kartikrajchauhan/Latype/BOM/hardware-corpus-cart.jpg

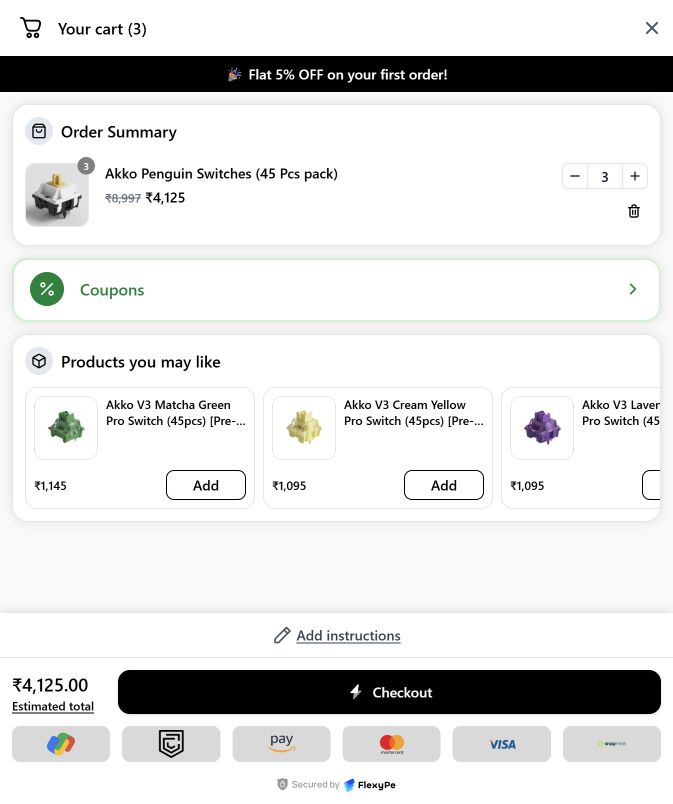
BOM/hardware-corpus-cart.jpg
