kartikrajchauhan/Latype/Images/Screenshot 2026-10-20 131839.png

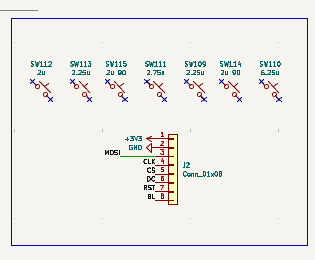
Images/Screenshot 2026-10-20 131839.png
