kartikrajchauhan/Latype/Images/Screenshot 2026-10-20 131844.png

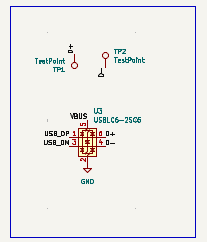
Images/Screenshot 2026-10-20 131844.png
