kartikrajchauhan/Latype/Images/Screenshot 2026-10-20 131846.png

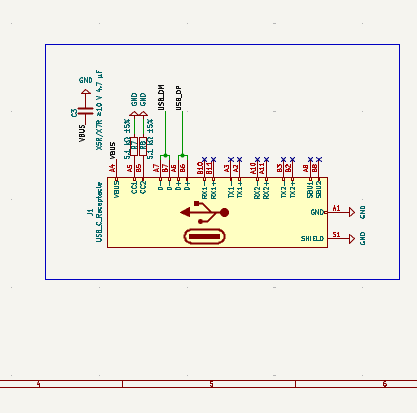
Images/Screenshot 2026-10-20 131846.png
