kartikrajchauhan/Latype/Images/Screenshot 2026-10-20 131850.png

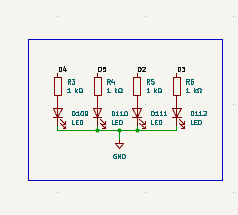
Images/Screenshot 2026-10-20 131850.png
