kartikrajchauhan/Latype/BOM/digikey-cart-components-1.jpg

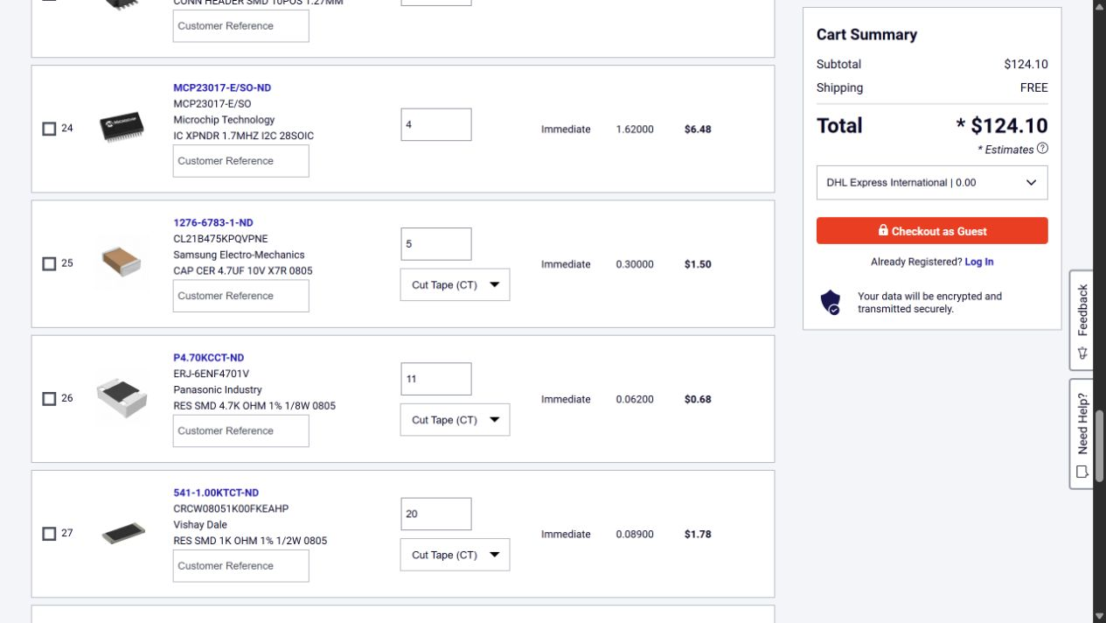
BOM/digikey-cart-components-1.jpg
