kartikrajchauhan/Latype/BOM/digikey-cart-components-3.jpg

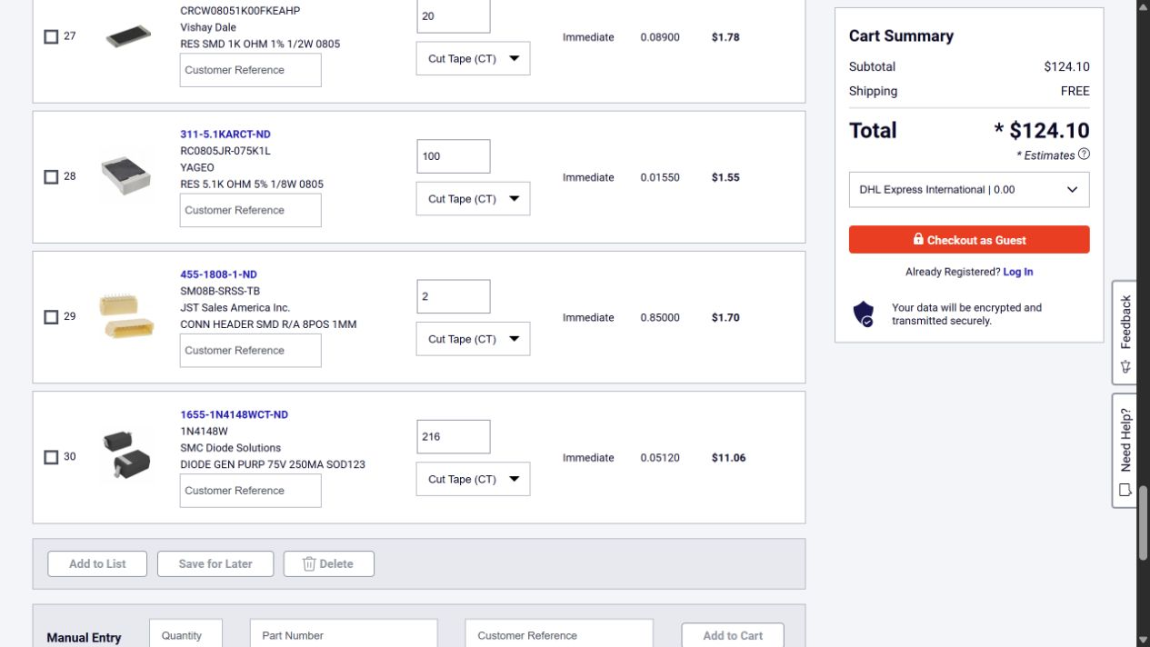
BOM/digikey-cart-components-3.jpg
