kartikrajchauhan/Latype/BOM/engineer-store-cart.jpg

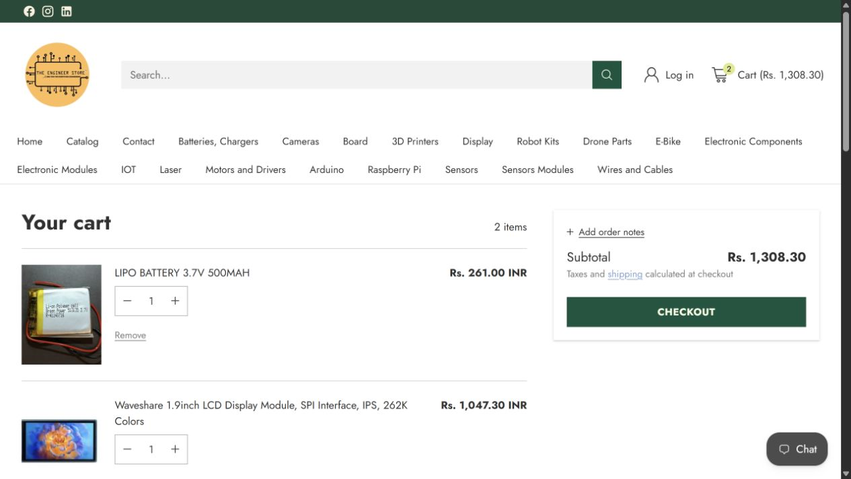
BOM/engineer-store-cart.jpg
