kartikrajchauhan/Latype/BOM/hubtronics-cart.jpg

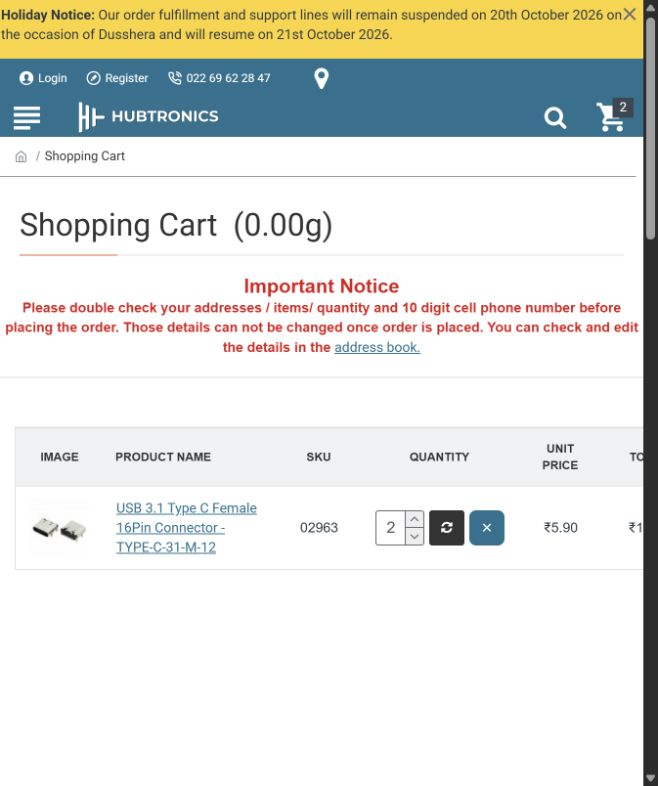
BOM/hubtronics-cart.jpg
