kartikrajchauhan/Latype/BOM/keycrox-cart.jpg

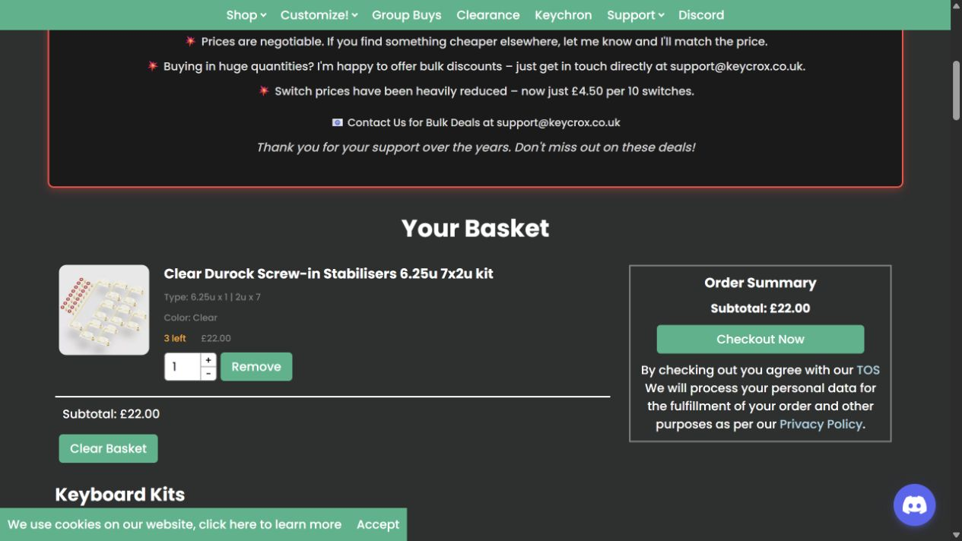
BOM/keycrox-cart.jpg
