kartikrajchauhan/Latype/BOM/lcsc-cart.jpg

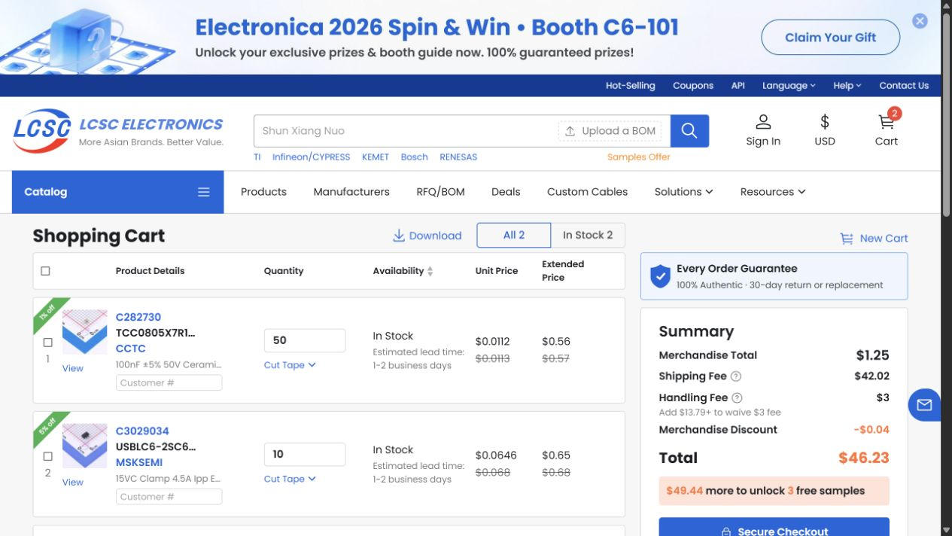
BOM/lcsc-cart.jpg
