kartikrajchauhan/Latype/BOM/quartz-components-cart.jpg

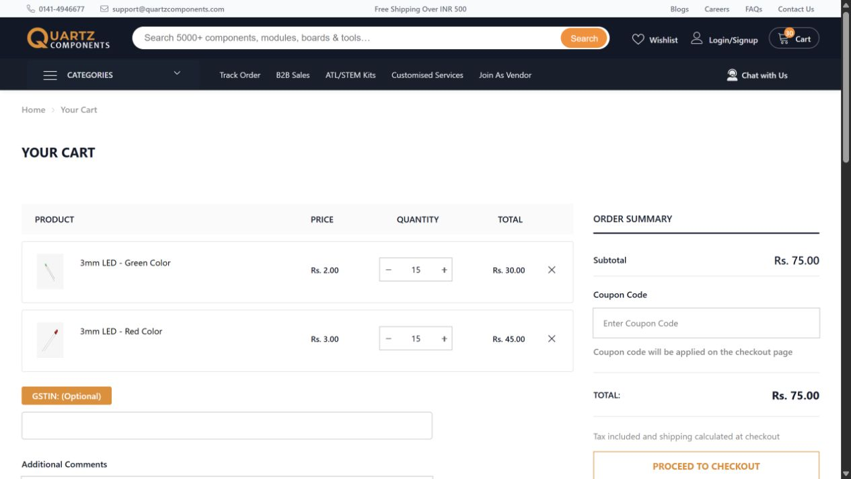
BOM/quartz-components-cart.jpg
