kartikrajchauhan/Latype/BOM/roboticsdna-cart.jpg

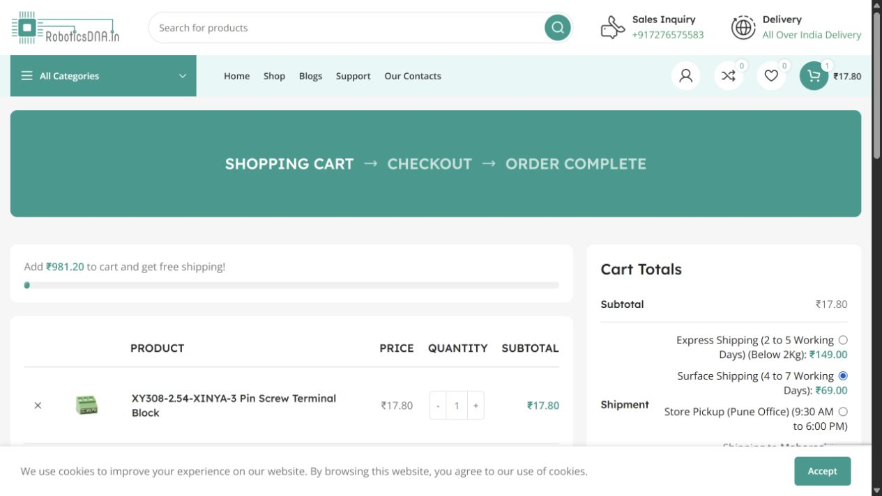
BOM/roboticsdna-cart.jpg
