kartikrajchauhan/Latype/BOM/Screenshot 2026-10-20 181608.png

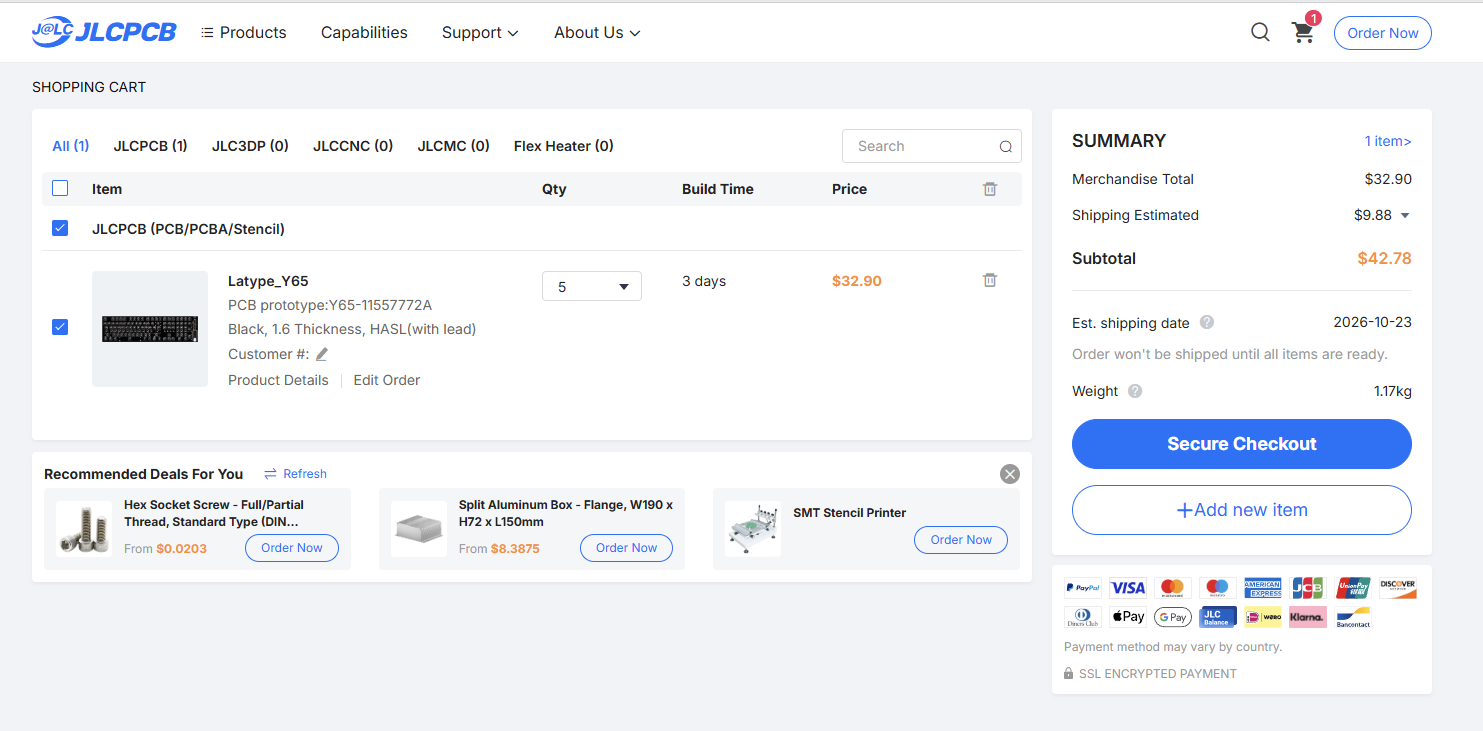
BOM/Screenshot 2026-10-20 181608.png
