kartikrajchauhan/Latype/BOM/Screenshot 2026-10-20 181613.png

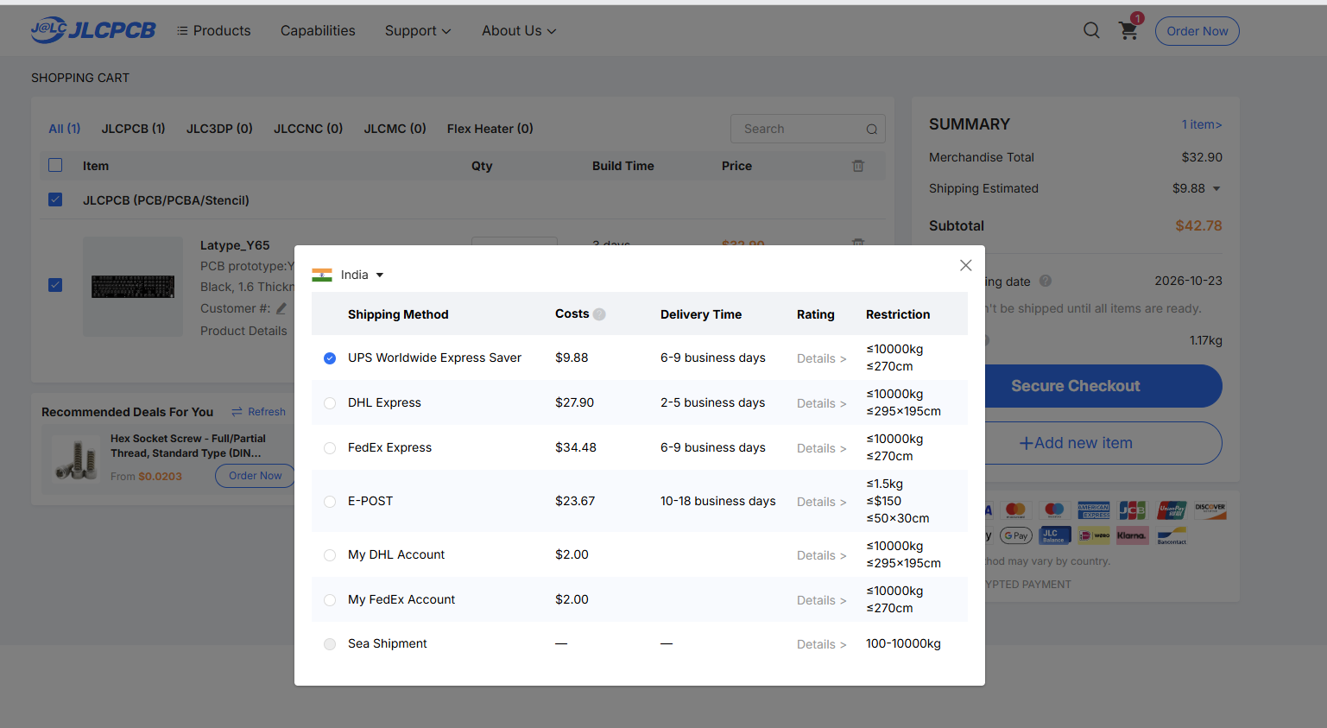
BOM/Screenshot 2026-10-20 181613.png
