kartikrajchauhan/Latype/BOM/tech-depot-cart.jpg

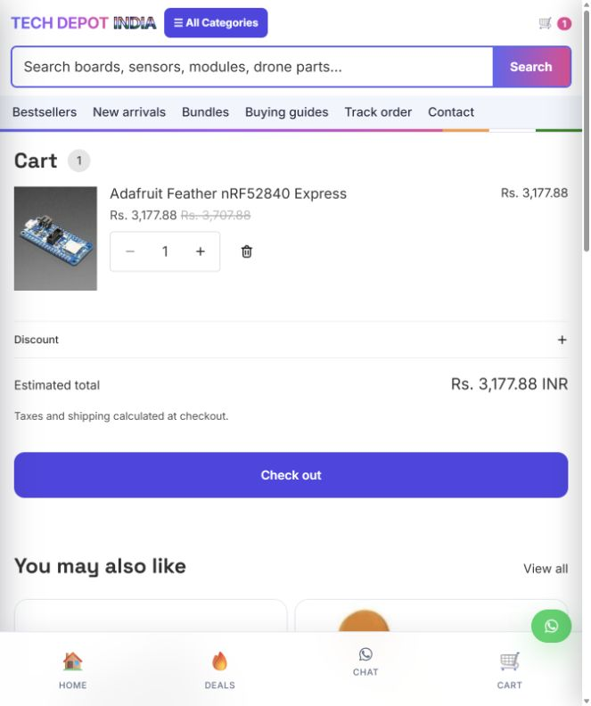
BOM/tech-depot-cart.jpg
