kartikrajchauhan/Latype/BOM/xvx-cart.jpg

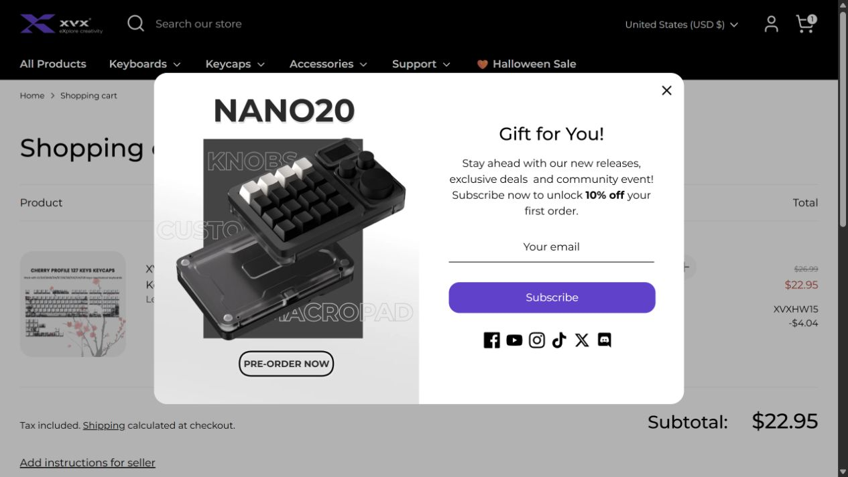
BOM/xvx-cart.jpg
