kartikrajchauhan/Latype/3D Mod/Print/Bottom.stl

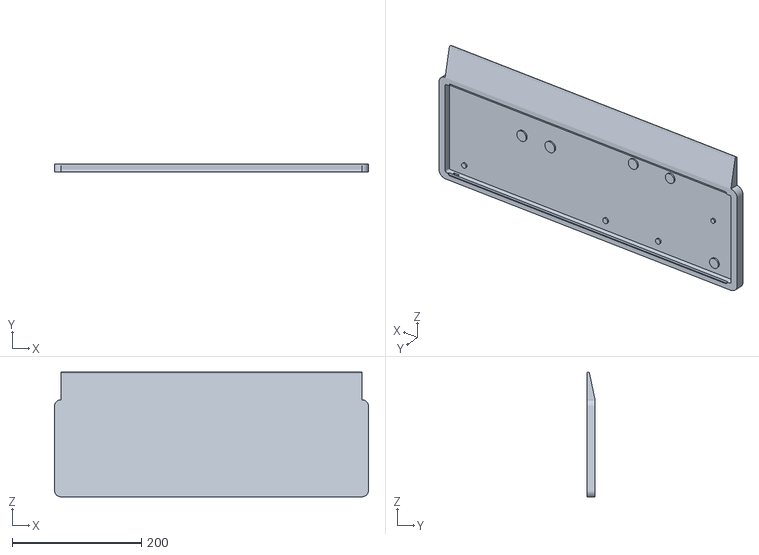
[picture p34: CAD file, 2026-10-20]
3D Mod/Print/Bottom.stl
485.0 x 12.7 x 192.6
