kartikrajchauhan/Latype/PCB/nRF52830/4062-nRF52830-Feather.step

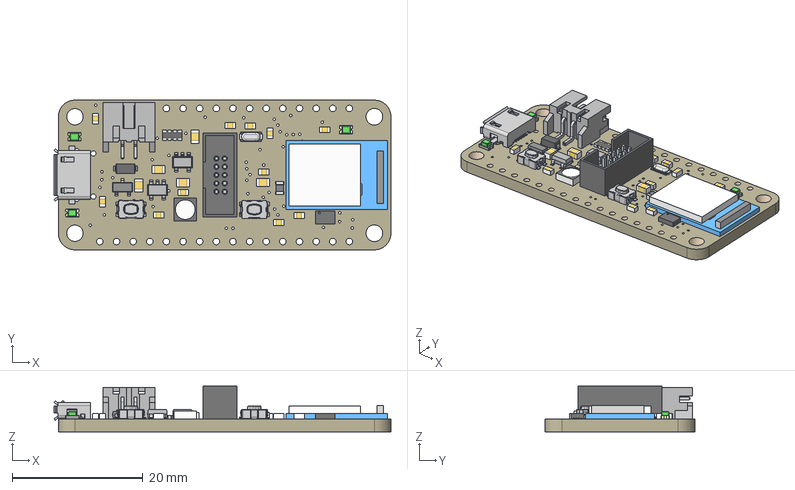
[picture p35: CAD file, 2026-10-20]
PCB/nRF52830/4062-nRF52830-Feather.step
51.5 x 22.9 x 6.99 mm
Board
2x5 0.05"
KMR2 x 2
AP2112(3.3V) x 2
BLUE x 3
JSTPH
4u20329
MBR120
DMG2305
MDBT50
GD25Q16
WS2812B3535
0.1uF x 11
10uF x 5
DNP
100K
