kartikrajchauhan/Latype/3D Mod/Print/Plate.stl

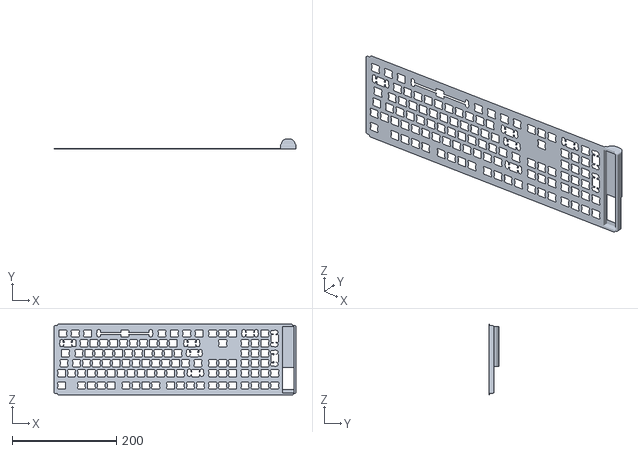
[picture p36: CAD file, 2026-10-20]
3D Mod/Print/Plate.stl
465.0 x 19.5 x 136.0
