kartikrajchauhan/Latype/3D Mod/Print/Top Plate.stl

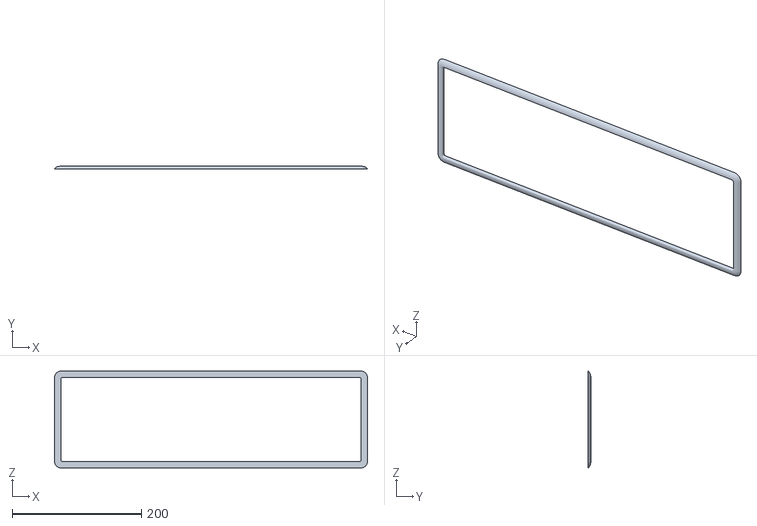
[picture p37: CAD file, 2026-10-20]
3D Mod/Print/Top Plate.stl
485.0 x 4.00 x 150.0
