kartikrajchauhan/Latype/(list of files, cad)

Other CAD files:
3D Mod/Full/Equinox V1.step
Fusion360/Latype.f3d
