kartikrajchauhan/Latype/PDF/Latype Schematic.pdf

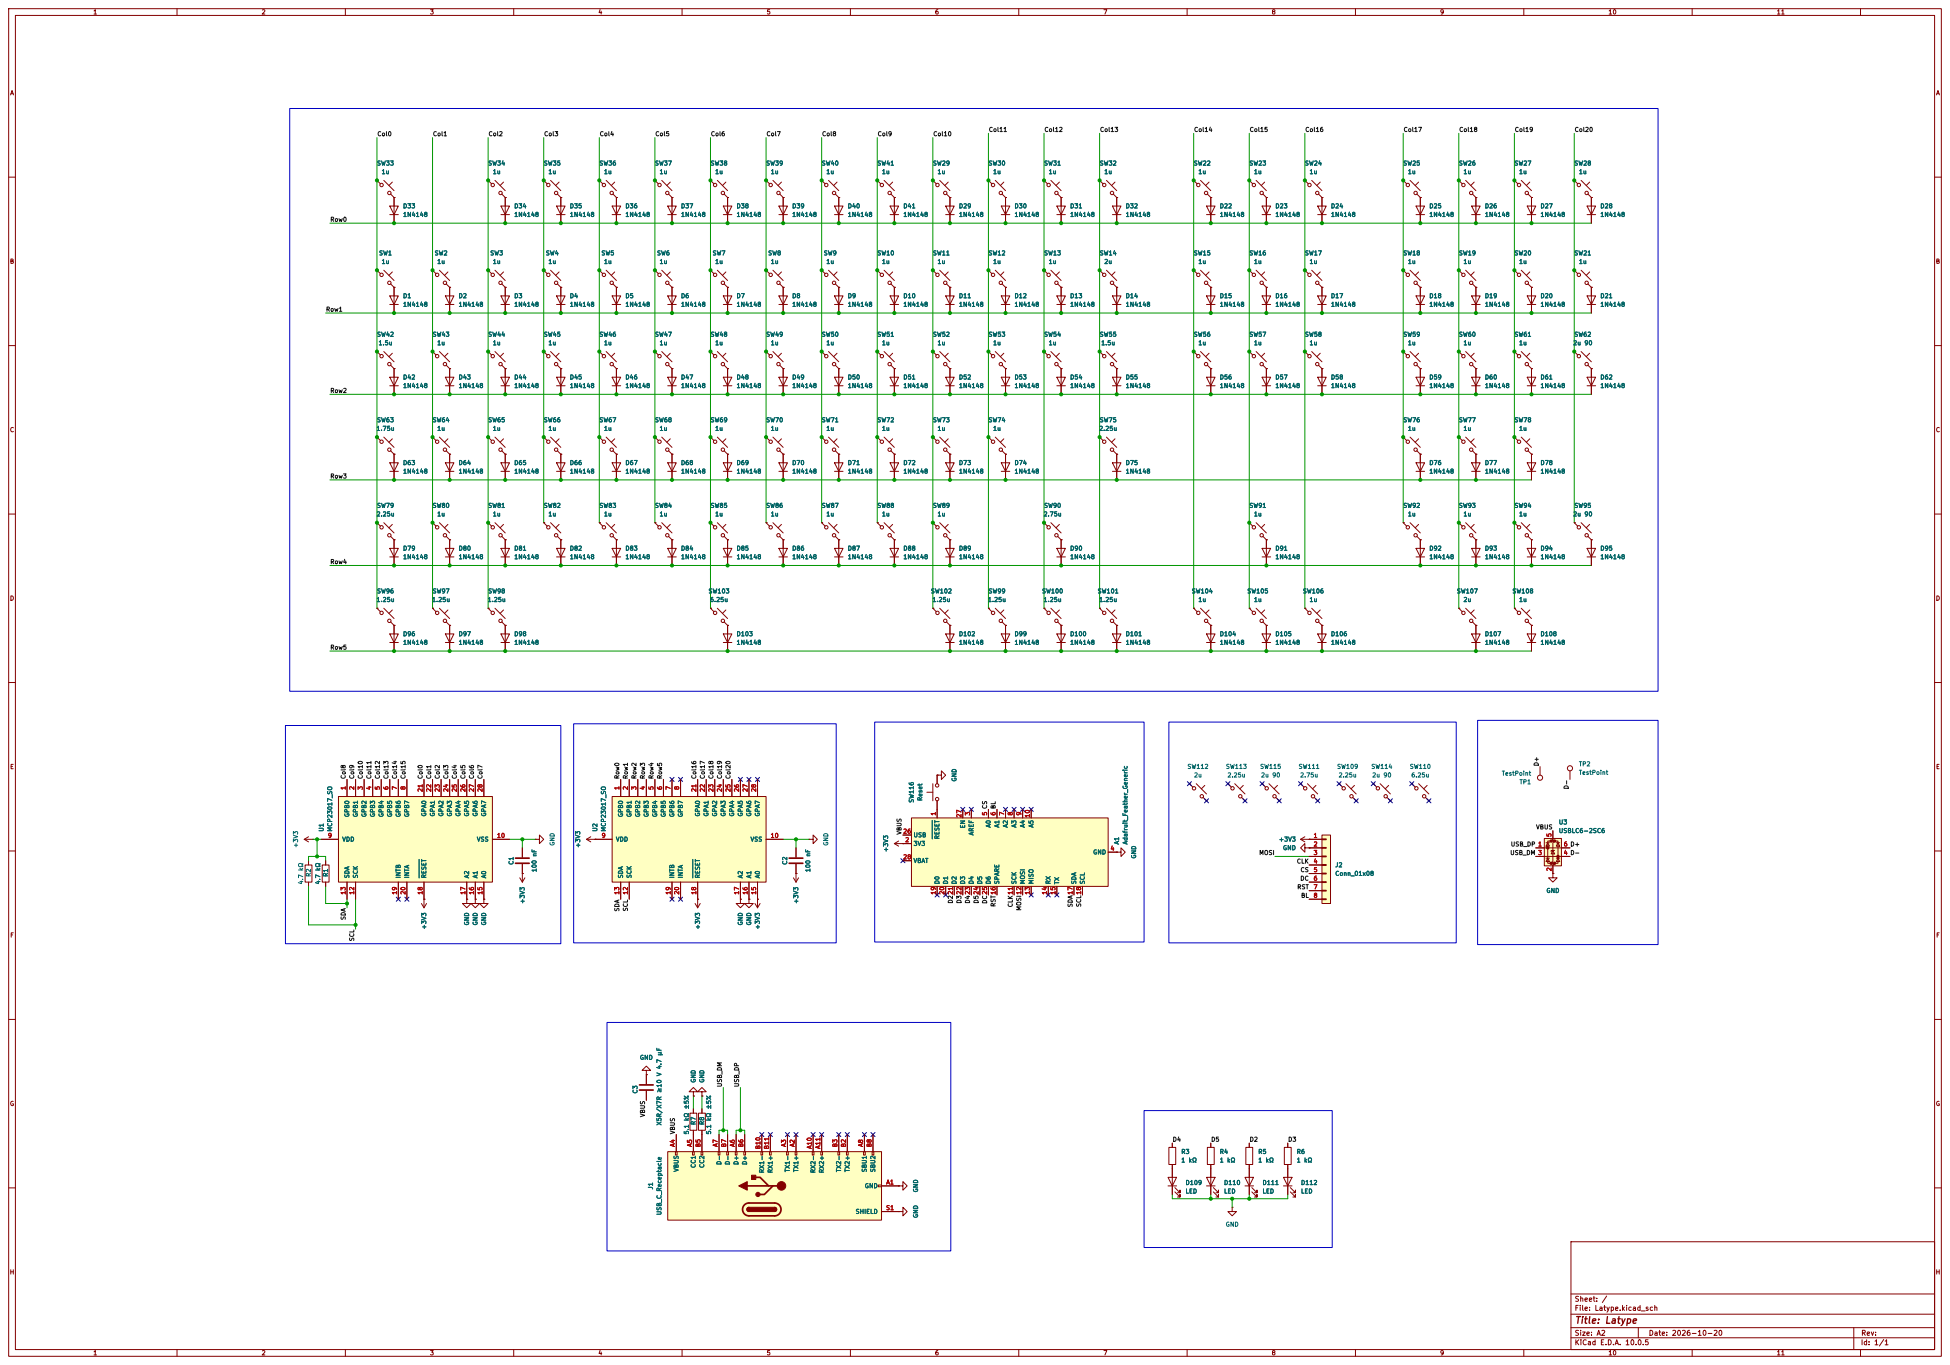
[picture p38: page 1]

9 A5 10 SCK 11 MOSI 12 MISO 13 RX 14 TX 15 SPARE 16 SDA 17 SCL 18 D0 19 D1 20 D2 21 D3 22 D4 23 D5 24 D6 25 USB 26 EN 27

Size: A2 | Rev:
KiCad E.D.A. 10.0.5 | Id: 1/1
