kartikrajchauhan/Latype/PDF/Latype-B_Cu.pdf

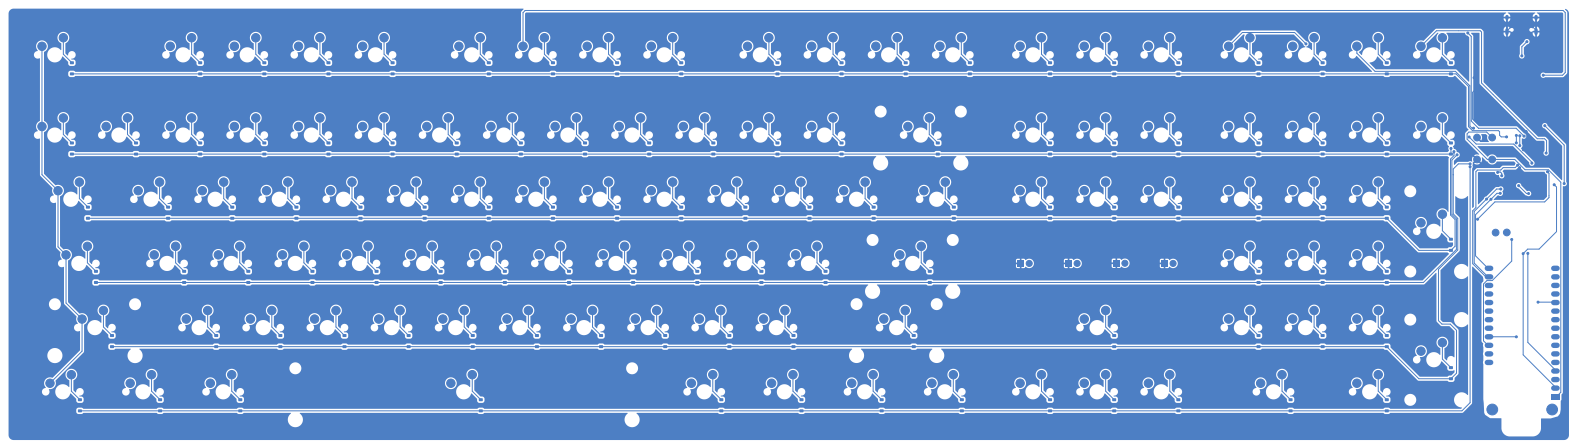
[picture p39: page 1]
