kartikrajchauhan/Latype/PDF/Latype-B_Mask.pdf

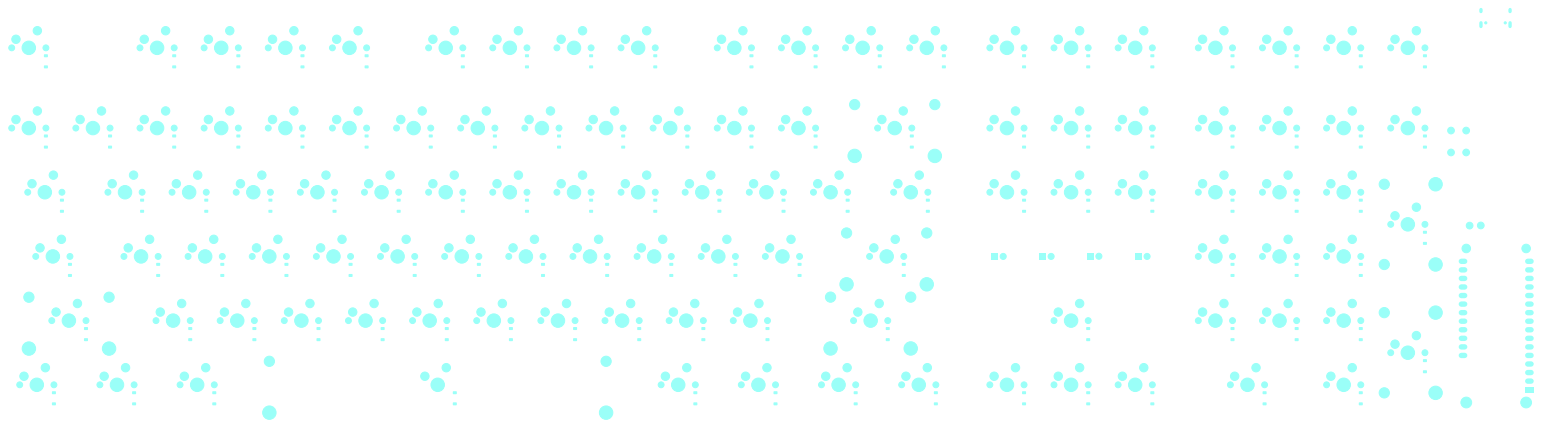
[picture p40: page 1]
