kartikrajchauhan/Latype/PDF/Latype-B_Paste.pdf

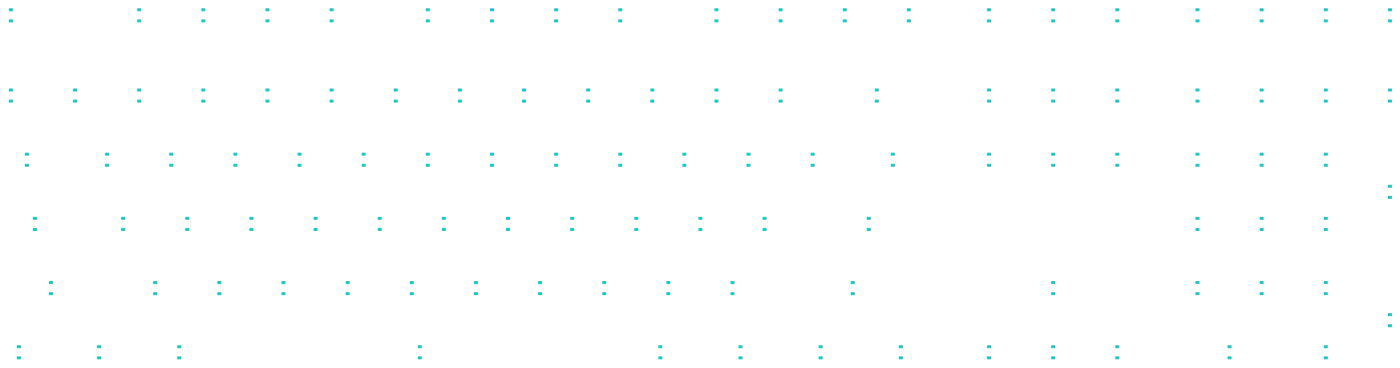
[picture p41: page 1]
