kartikrajchauhan/Latype/PDF/Latype-B_Silkscreen.pdf

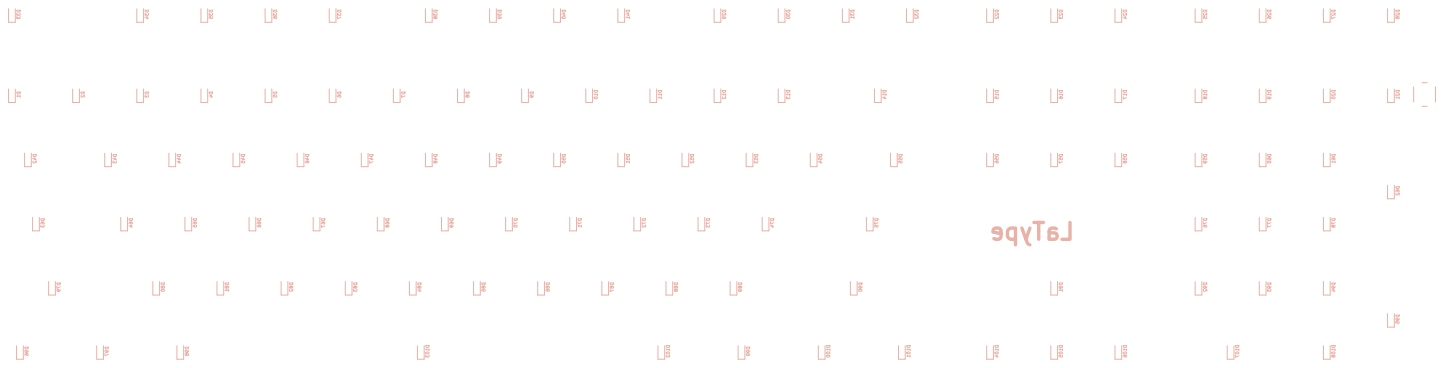
[picture p42: page 1]
