kartikrajchauhan/Latype/PDF/Latype-Edge_Cuts.pdf

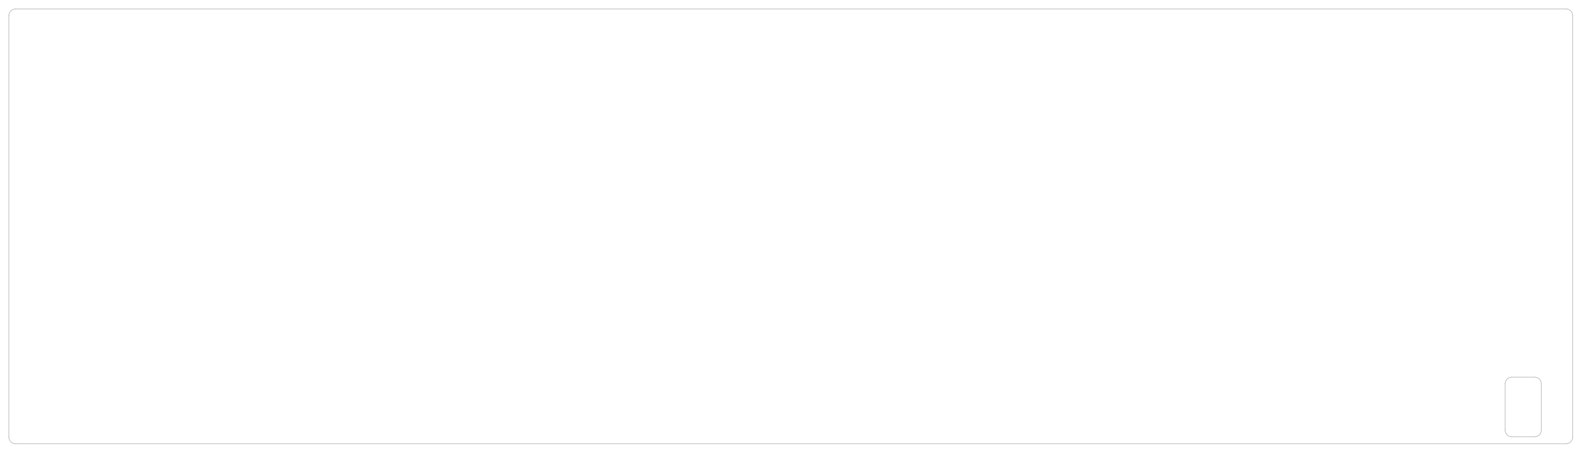
[picture p43: page 1]
