kartikrajchauhan/Latype/PDF/Latype-F_Cu.pdf

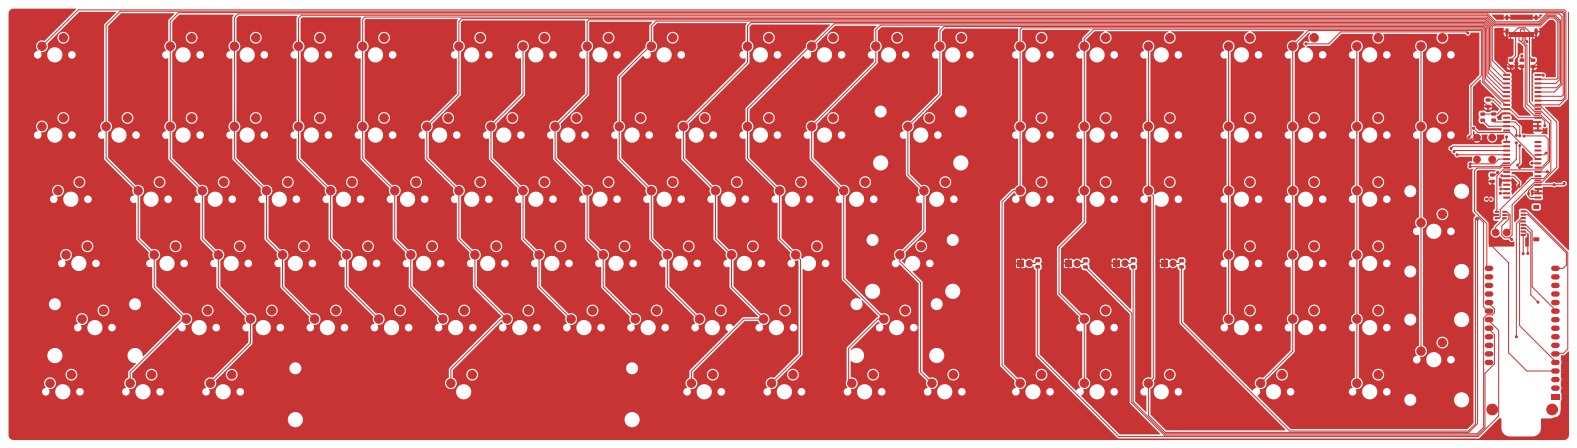
[picture p44: page 1]
