kartikrajchauhan/Latype/PDF/Latype-F_Mask.pdf

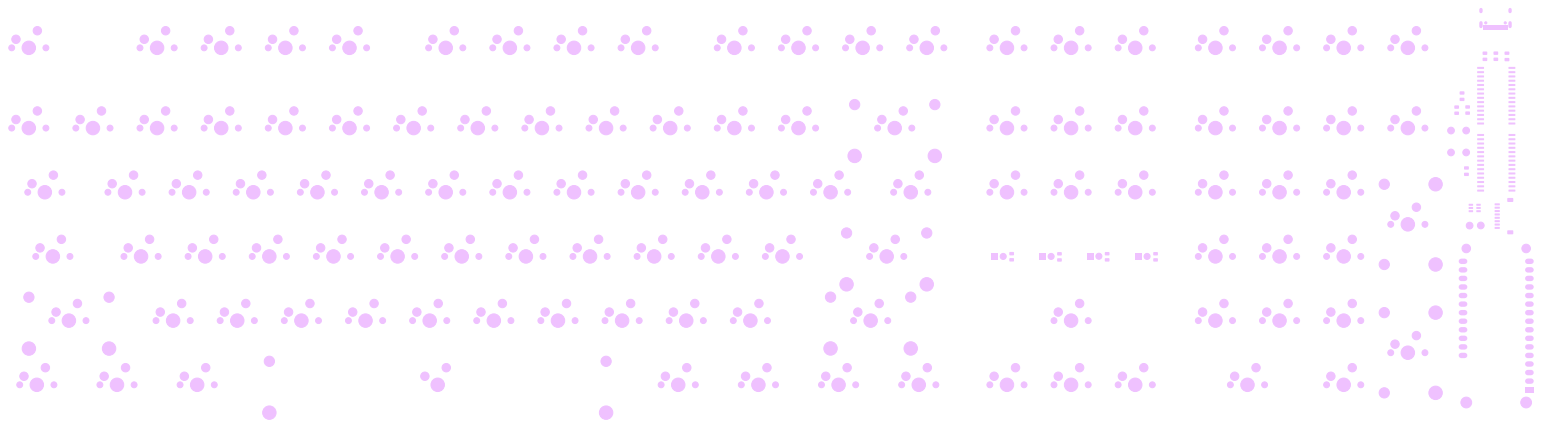
[picture p45: page 1]
