kartikrajchauhan/Latype/PDF/Latype-F_Paste.pdf

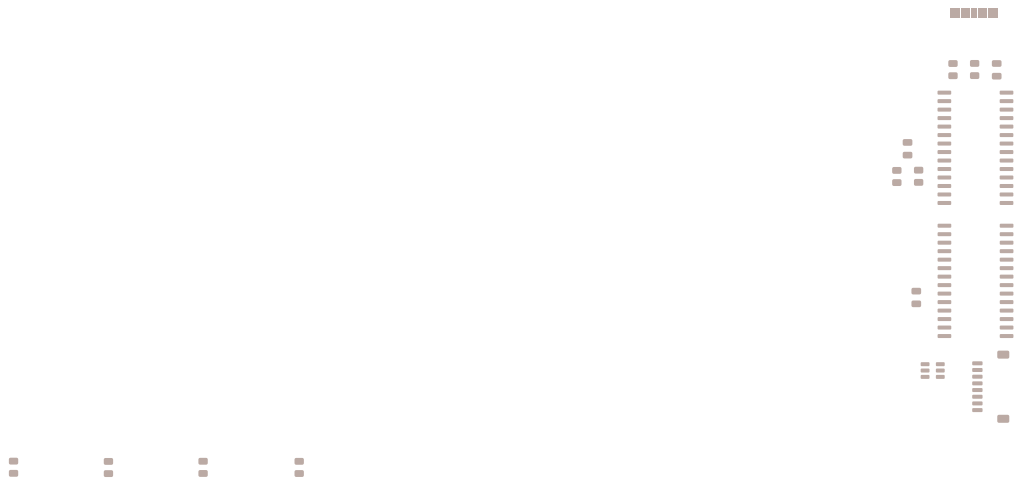
[picture p46: page 1]
