kartikrajchauhan/Latype/PDF/Latype-F_Silkscreen.pdf

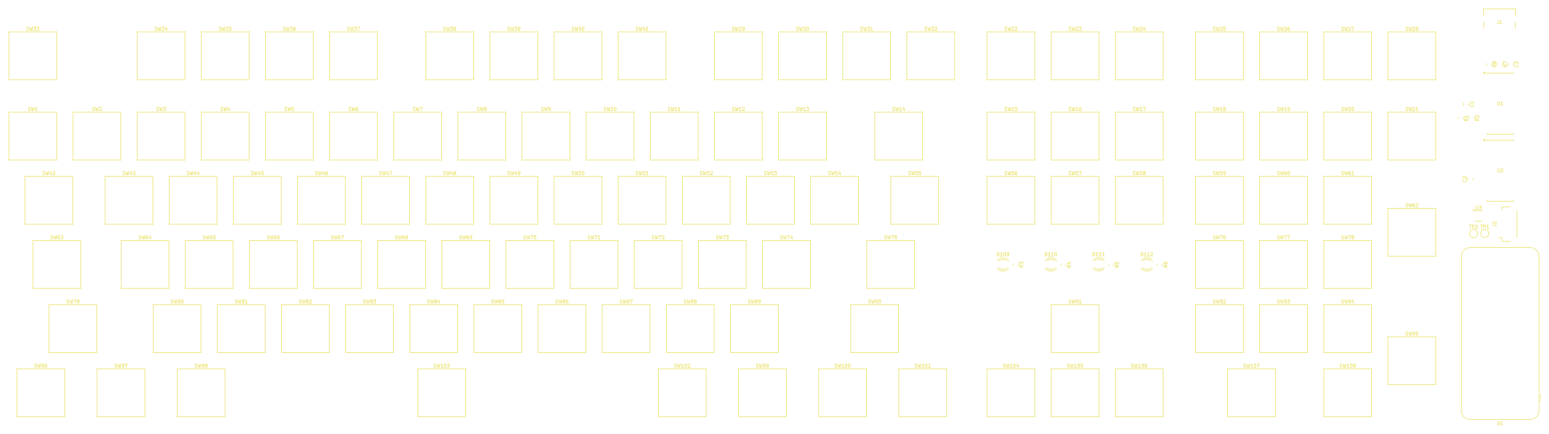
[picture p47: page 1]
